illumneo/capkey/kicad/capacitive_touch_4x4_18mm/capacitive_touch_4x4_18mm.kicad_sch

## KiCad design kicad/capacitive_touch_4x4_18mm/capacitive_touch_4x4_18mm.kicad_sch (2025-06-13)

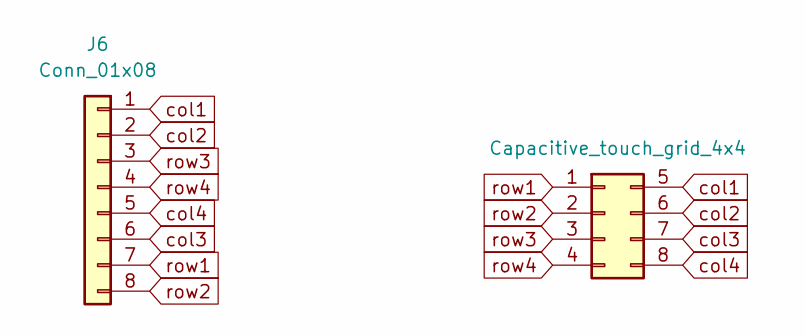
[picture p1: schematic capacitive_touch_4x4_18mm.kicad_sch]

Parts:
J4: Capacitive_touch_grid_4x4; grid_4x4
J6: Conn_01x08; esp32_s3_partial

Connections:
col1: J4.5, J6.1
col2: J4.6, J6.2
col3: J4.7, J6.6
col4: J4.8, J6.5
row1: J4.1, J6.7
row2: J4.2, J6.8
row3: J4.3, J6.3
row4: J4.4, J6.4
