illumneo/capkey/fw/arduino_tests/touchpad.h

#pragma once
#include "Arduino.h"
#include "driver/touch_sens.h"

extern uint32_t scans;

struct TouchpadPosition {
    int32_t readings[8];
    uint32_t timestamp;
    void read(float &x, float &y, float &z);
};

class Touchpad {
    public:
        Touchpad(touch_sensor_handle_t& sens_handle, uint8_t channel_id[8], QueueHandle_t& position_queue);

        void initTouch();
        // void processInputs();
        void sendPosition();
        // void calculatePosition();

        // void read(float &x, float &y, float &z);

    private:
        touch_sensor_handle_t& sens_handle_;
        uint8_t channel_id_[8];
        QueueHandle_t& position_queue_;

        touch_channel_handle_t chan_handle_[8];
        int32_t readings_[8];
        uint32_t benchmark_[8];

        // float x_, y_, z_;
};
