illumneo/capkey/(commit log)

2025-06-06 Add script to make SVGs for capacitive touch pad layouts
    Creates SVG files containing capacitive touch pad layouts with:
    - Diamond-shaped pads arranged in rows and columns
    - Connecting traces between pads
    - Configurable pad spacing, size and corner radius
    - Also starts process for generating petal-shaped pads
2025-06-07 Improve flower pad design and add dev log
    - Redesign flower pad geometry so the spacing is correct
    - Add devlog.md with project documentation and development notes
2025-06-07 Add flower-shaped capacitive touch pad layout generator
    - Add create_flower_pad() function to generate flower-shaped pads
    - Each pad has 2-4 petals depending on edge position
    - Petals connected by stems to central pad
    - Update grid and row functions to work with both pad styles
    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
2025-06-08 refactor: Convert touch pad to object-oriented design
    - Convert functional pad generation to class-based implementation
    - Create abstract base Pad class with DiamondPad and FlowerPad subclasses
    - Introduce TouchGrid class to handle grid generation and layout
    - Remove standalone functions in favor of class methods
    - Simplify pad configuration and generation interface
    - Clean up commented-out code and improve code organization
    This refactoring improves code maintainability and extensibility by:
    - Encapsulating pad-specific logic in dedicated classes
    - Making it easier to add new pad types by subclassing Pad
    - Reducing code duplication through inheritance
    - Providing a cleaner interface for gr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
2025-06-08 Add demo class, clean up code, and bug fixes
    - Add demo functionality to showcase different pad configurations
    - Update main script to use new demo functionality
    - Refactor code to be more modular with new pad layout classes
    - Fix trace width and stroke width calculations
    This commit improves the code quality and adds new features to the
    capacitive touch pad generation script while maintaining backward
    compatibility.
2025-06-12 Enhance SVG generation for capacitive touch pads
    - Added a method to generate back traces for connecting vias on the
    back side of the board.
    - Introduced an 'origin' circle in the SVG output to aid alignment in KiCad.
    - Updated the TouchGrid class to include back trace generation functionality.
2025-06-13 Add kicad project
    Kicad project for 18mm grid capacitive touch pads,
    which is what I ordered from OSH Park.
    [capacitive_touch_4x4_18mm.kicad_pcb, capacitive_touch_4x4_18mm.kicad_sch]
2025-07-03 Add simple arduino test code for reading touch pad position
2025-08-02 Add gesture detection and output for touchpad
    - Implemented basic gesture recognition in `arduino_tests.ino`:
    - Detects taps and swipes in 8 directions using centroid calculation and angle.
    - Outputs gesture type and corresponding character.
    - Added state machine for gesture tracking and calculation.
    - Adjusted axis scaling for improved position accuracy.
2025-08-14 Improve detection by switching to ESP-IDF interface
    - Switched to ESP-IDF touch interface for more reliable readings
    - Refactored touch reading and gesture FSM for better accuracy
    - Updated plotting script to connect the dots when plotting
2025-08-15 Refactor touchpad logic into a separate class
    - Create a new Touchpad class to handle reading the touch sensors
    - Add USB keyboard support
2025-08-16 Refactor gesture detection into a class
    - Switch to interrupt driven design
    - Move gesture recognition/keyboard to a separate thread
2025-10-15 Add a larger touch pad & modify design for jlcpcb
    - Create new 50mm touch pad design with 6x6 grid
    - Modify design to be suitable for jlcpcb
    - Update scripts to generate new 6x6 design outputs
    - Add silkscreen script to produce silkscreen SVGs for keyboard
    [capacitive_touch_4x4_18mm.kicad_pcb, capacitive_touch_6x6_50mm.kicad_pcb, capacitive_touch_6x6_50mm.kicad_sch]
2025-10-15 Add QR codes and final graphic changes to pcb
    [capacitive_touch_6x6_50mm.kicad_pcb]
2025-10-15 Add generated build files and final changes
    [capacitive_touch_4x4_18mm.kicad_pcb]
2025-11-01 Swap rows and add long swipes for space and backspace
    [arduino_tests.ino, gesture.cpp, gestureDetector.cpp, gestureDetector.h, keyMap.cpp]
